ENACRobotique/PAMIS/README.md

# PAMIS_2024

Limiter le courant des stepper à 0.6 A

Enlever les solder bridges SB9 SB16 et SB18 de la nucleo L432KC
