ENACRobotique/PAMIS/2026/pamis_2026/README.md

# PAMIs 2026

Carte basée sur un ESP32-S3.

- [ESP-IDF installation Guide](https://docs.espressif.com/projects/esp-idf/en/latest/esp32/get-started/linux-setup.html)

# Configuration

Lancer le "SDK Configuration Editor", et configurer le SSID et le mot de passe du réseau WiFi auquel le PAMI doit se connecter.
