ENACRobotique/PAMIS/2026/pamis_2026/data/low_res.png

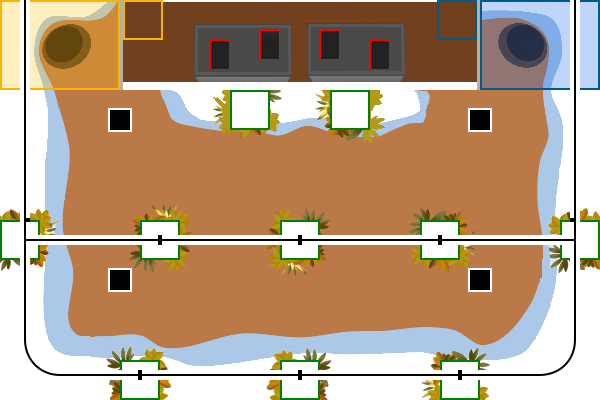
2026/pamis_2026/data/low_res.png
