ENACRobotique/PAMIS/2024/PAMI_soft/schematic.pdf

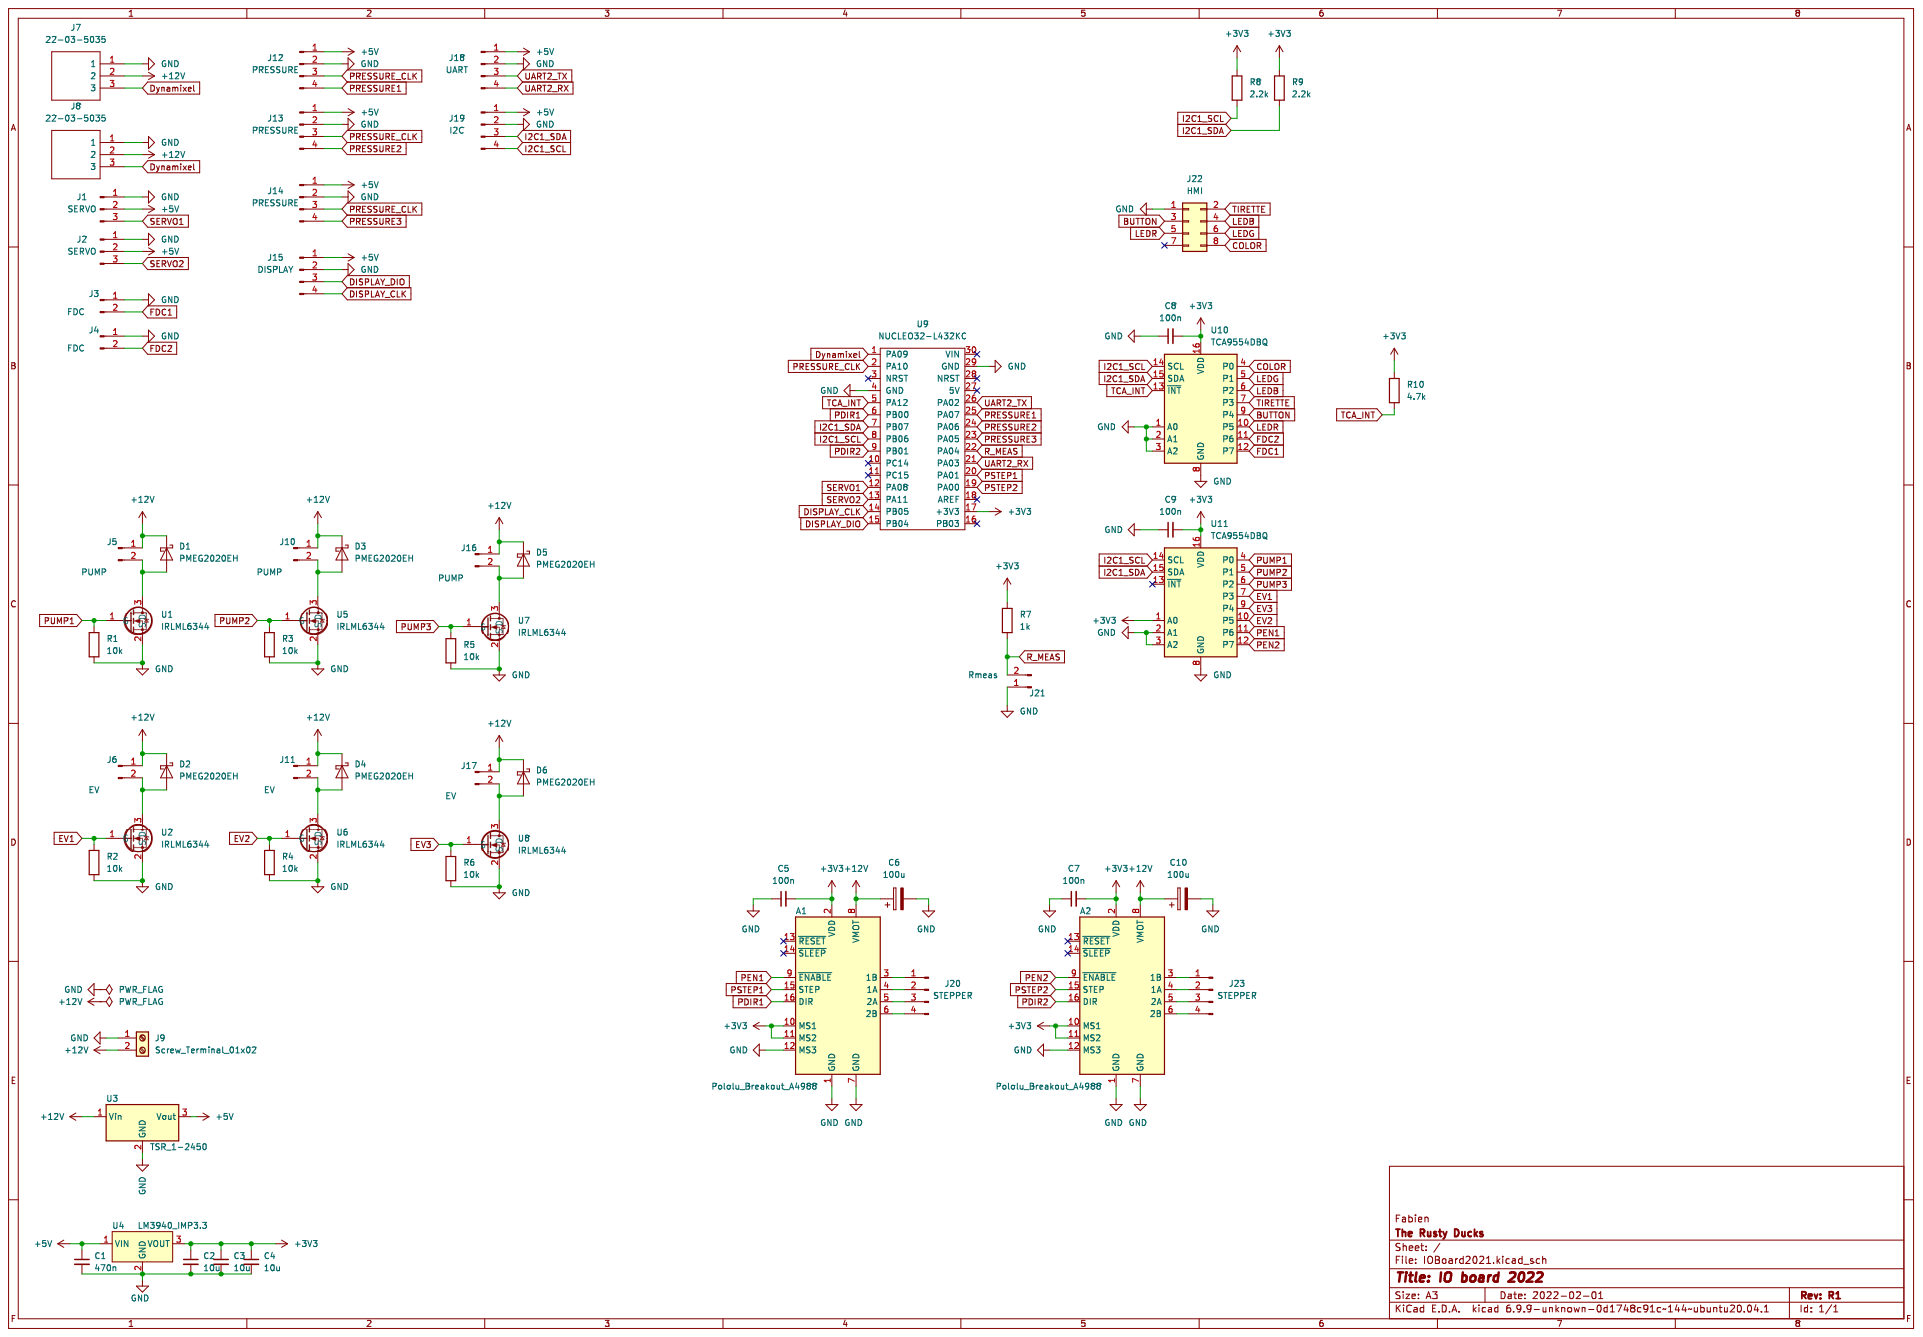
[picture p2: page 1]
