ENACRobotique/PAMIS/2025/carte_elec/pami.kicad_pcb

## KiCad design 2025/carte_elec/pami.kicad_pcb (2025-02-17)

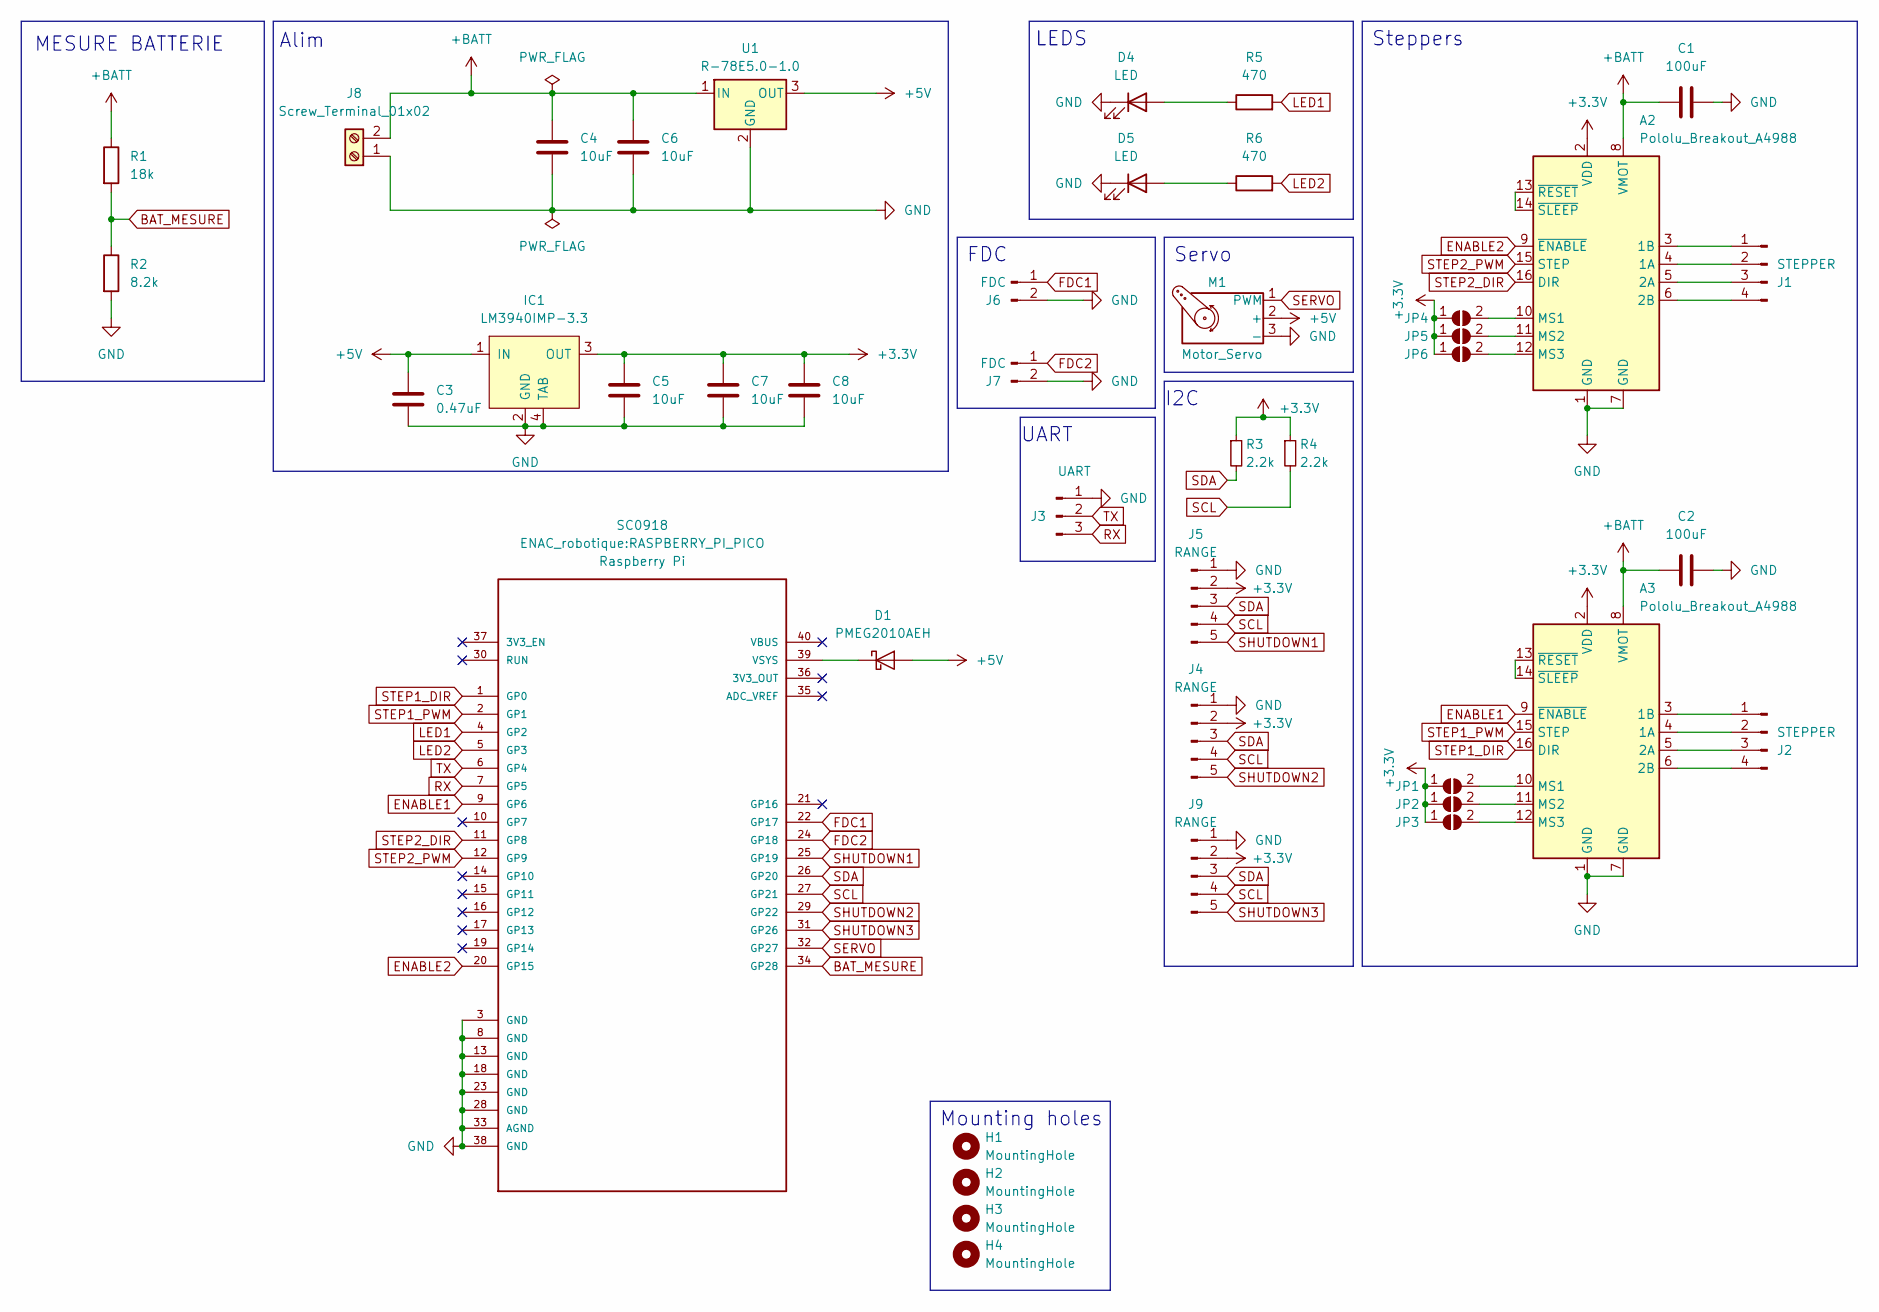
[picture p3: schematic pami.kicad_sch]

Parts:
A1: SC0918; RASPBERRY_PI_PICO; PARTREV 1.6
A2, A3: Pololu_Breakout_A4988; Pololu_Breakout-16_15.2x20.3mm
C1, C2: 100uF; CP_Elec_10x12.5
C3: 0.47uF; C_0805_2012Metric
C4, C5, C6, C7, C8: 10uF; C_0805_2012Metric
D1: PMEG2010AEH; D_SOD-123F
D4, D5: LED; LED_0603_1608Metric
H1, H2, H3, H4: MountingHole; MountingHole_3.2mm_M3
IC1: LM3940IMP-3.3; LM3940IMP
J1, J2: STEPPER; PinHeader_1x04_P2.54mm_Vertical
J3: UART; PinHeader_1x03_P2.54mm_Vertical
J4, J5, J9: RANGE; Molex_PicoBlade_53398-0571_1x05-1MP_P1.25mm_Vertical
J6, J7: FDC; PinHeader_1x02_P2.54mm_Vertical
J8: Screw_Terminal_01x02; TerminalBlock_bornier-2_P5.08mm
JP1, JP2, JP3, JP4, JP5, JP6: SolderJumper_2_Open; SolderJumper-2_P1.3mm_Open_TrianglePad1.0x1.5mm
M1: Motor_Servo; PinHeader_1x03_P2.54mm_Vertical
R1: 18k; R_0603_1608Metric
R2: 8.2k; R_0603_1608Metric
R3, R4: 2.2k; R_0805_2012Metric
R5, R6: 470; R_0603_1608Metric
U1: R-78E5.0-1.0; Converter_DCDC_RECOM_R-78E-0.5_THT

Connections:
+3.3V: A2.2 (VDD), A3.2 (VDD), C5.1, C7.1, C8.1, IC1.3 (OUT), J4.2, J5.2, J9.2, JP1.1 (A), JP2.1 (A), JP3.1 (A), JP4.1 (A), JP5.1 (A), JP6.1 (A), R3.1, R4.1
+5V: C3.1, D1.2 (A), IC1.1 (IN), M1.2 (+), U1.3 (OUT); also elsewhere on the board
+BATT: A2.8 (VMOT), A3.8 (VMOT), C1.1, C2.1, C4.2, C6.2, J8.2, R1.1, U1.1 (IN); also elsewhere on the board
BAT_MESURE: A1.34 (GP28), R1.2, R2.1
ENABLE1: A1.9 (GP6), A3.9 (~ENABLE)
ENABLE2: A1.20 (GP15), A2.9 (~ENABLE)
FDC1: A1.22 (GP17), J6.1; also elsewhere on the board
FDC2: A1.24 (GP18), J7.1; also elsewhere on the board
GND: A1.3 (GND), A1.8 (GND), A1.13 (GND), A1.18 (GND), A1.23 (GND), A1.28 (GND), A1.33 (AGND), A1.38 (GND), A2.1 (GND), A2.7 (GND), A3.1 (GND), A3.7 (GND), C1.2, C2.2, C3.2, C4.1, C5.2, C6.1, C7.2, C8.2, D4.1 (K), D5.1 (K), IC1.2 (GND), IC1.4 (TAB), J3.1, J4.1, J5.1, J6.2, J7.2, J8.1, J9.1, M1.3 (-), R2.2, U1.2 (GND); also elsewhere on the board
LED1: A1.4 (GP2), R5.2
LED2: A1.5 (GP3), R6.2
unnamed: A1.39 (VSYS), D1.1 (K)
unnamed: A2.4 (1A), J1.2
unnamed: A2.3 (1B), J1.1
unnamed: A2.5 (2A), J1.3
unnamed: A2.6 (2B), J1.4
unnamed: A2.10 (MS1), JP4.2 (B)
unnamed: A2.11 (MS2), JP5.2 (B)
unnamed: A2.12 (MS3), JP6.2 (B)
unnamed: A2.13 (~RESET), A2.14 (~SLEEP)
unnamed: A3.4 (1A), J2.2
unnamed: A3.3 (1B), J2.1
unnamed: A3.5 (2A), J2.3
unnamed: A3.6 (2B), J2.4
unnamed: A3.10 (MS1), JP1.2 (B)
unnamed: A3.11 (MS2), JP2.2 (B)
unnamed: A3.12 (MS3), JP3.2 (B)
unnamed: A3.13 (~RESET), A3.14 (~SLEEP)
unnamed: D4.2 (A), R5.1
unnamed: D5.2 (A), R6.1
RX: A1.7 (GP5), J3.3
SCL: A1.27 (GP21), J4.4, J5.4, J9.4, R4.2
SDA: A1.26 (GP20), J4.3, J5.3, J9.3, R3.2
SERVO: A1.32 (GP27), M1.1 (PWM)
SHUTDOWN1: A1.25 (GP19), J5.5
SHUTDOWN2: A1.29 (GP22), J4.5
SHUTDOWN3: A1.31 (GP26), J9.5
STEP1_DIR: A1.1 (GP0), A3.16 (DIR)
STEP1_PWM: A1.2 (GP1), A3.15 (STEP)
STEP2_DIR: A1.11 (GP8), A2.16 (DIR)
STEP2_PWM: A1.12 (GP9), A2.15 (STEP)
TX: A1.6 (GP4), J3.2

Notes on the sheet:
Steppers
FDC
I2C
LEDS
Alim
Servo
UART
Mounting holes
MESURE BATTERIE

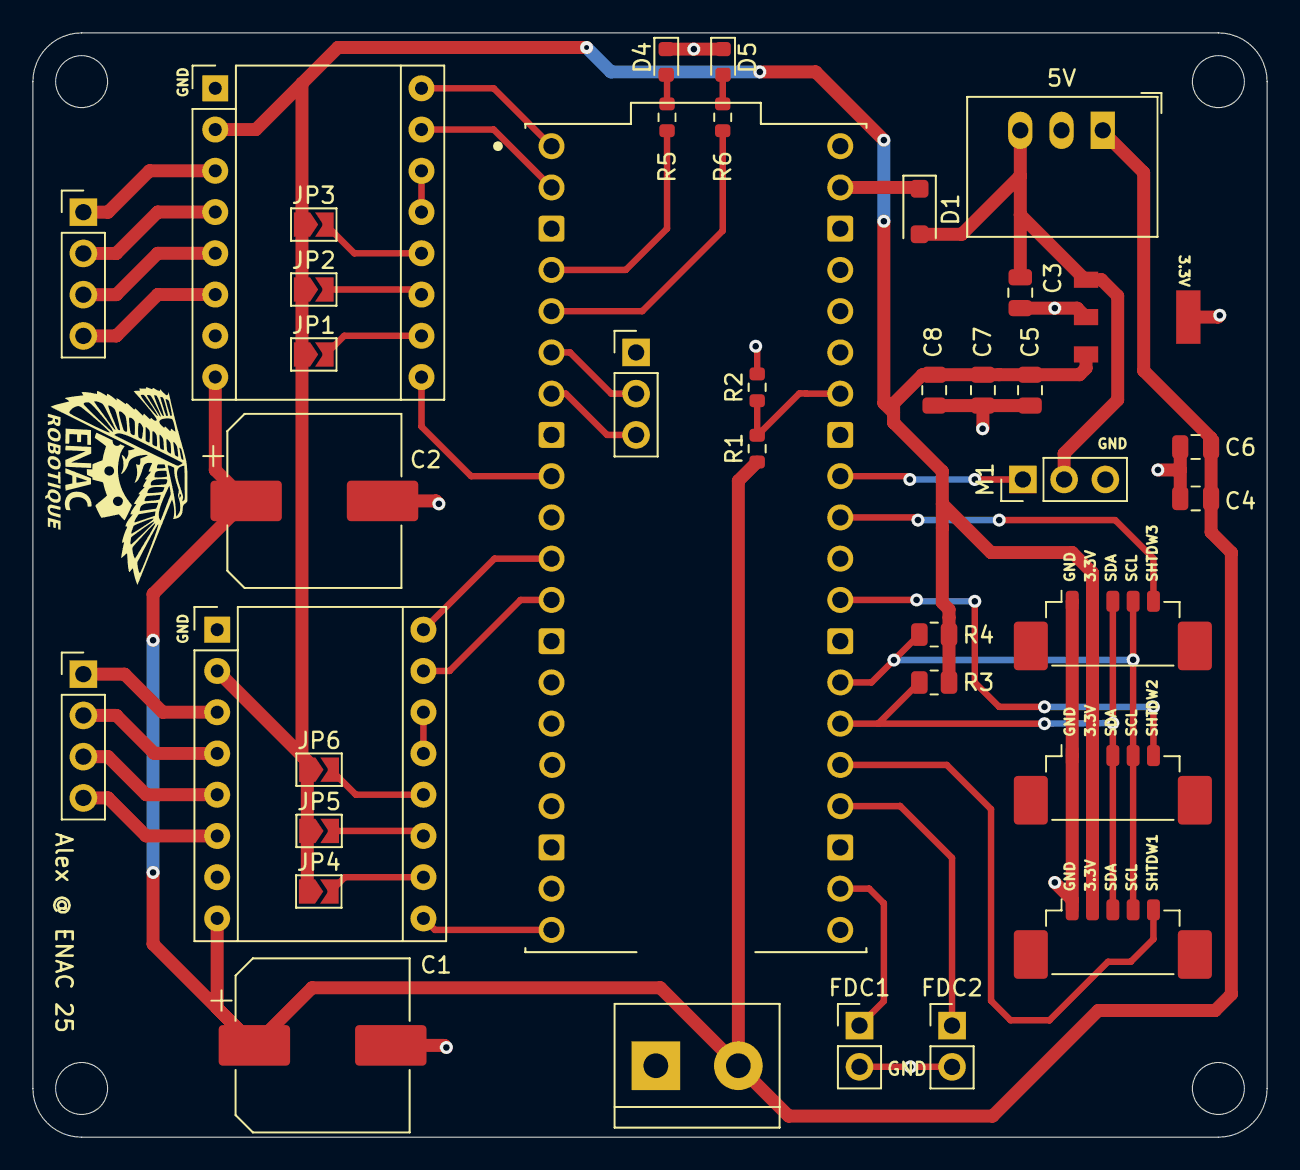
[picture p4: board pami.kicad_pcb from above]

Board: 2 copper layers, 76.0 x 68.0 mm, 42 parts (0 on the bottom side), 42 nets.

Other parts of the board:
5V: R-78E5.0-1.0; Converter_DCDC_RECOM_R-78E-0.5_THT
FDC1, FDC2: FDC; PinHeader_1x02_P2.54mm_Vertical

Their connections:
+5V: 5V.3 (OUT); also elsewhere on the board
+BATT: 5V.1 (IN); also elsewhere on the board
FDC1: FDC1.1; also elsewhere on the board
FDC2: FDC2.1; also elsewhere on the board
GND: 5V.2 (GND), FDC1.2, FDC2.2; also elsewhere on the board
