ENACRobotique/PAMIS/2024/carte_pami/carte_pami.kicad_pcb

## KiCad design 2024/carte_pami/carte_pami.kicad_pcb (2023-12-06)

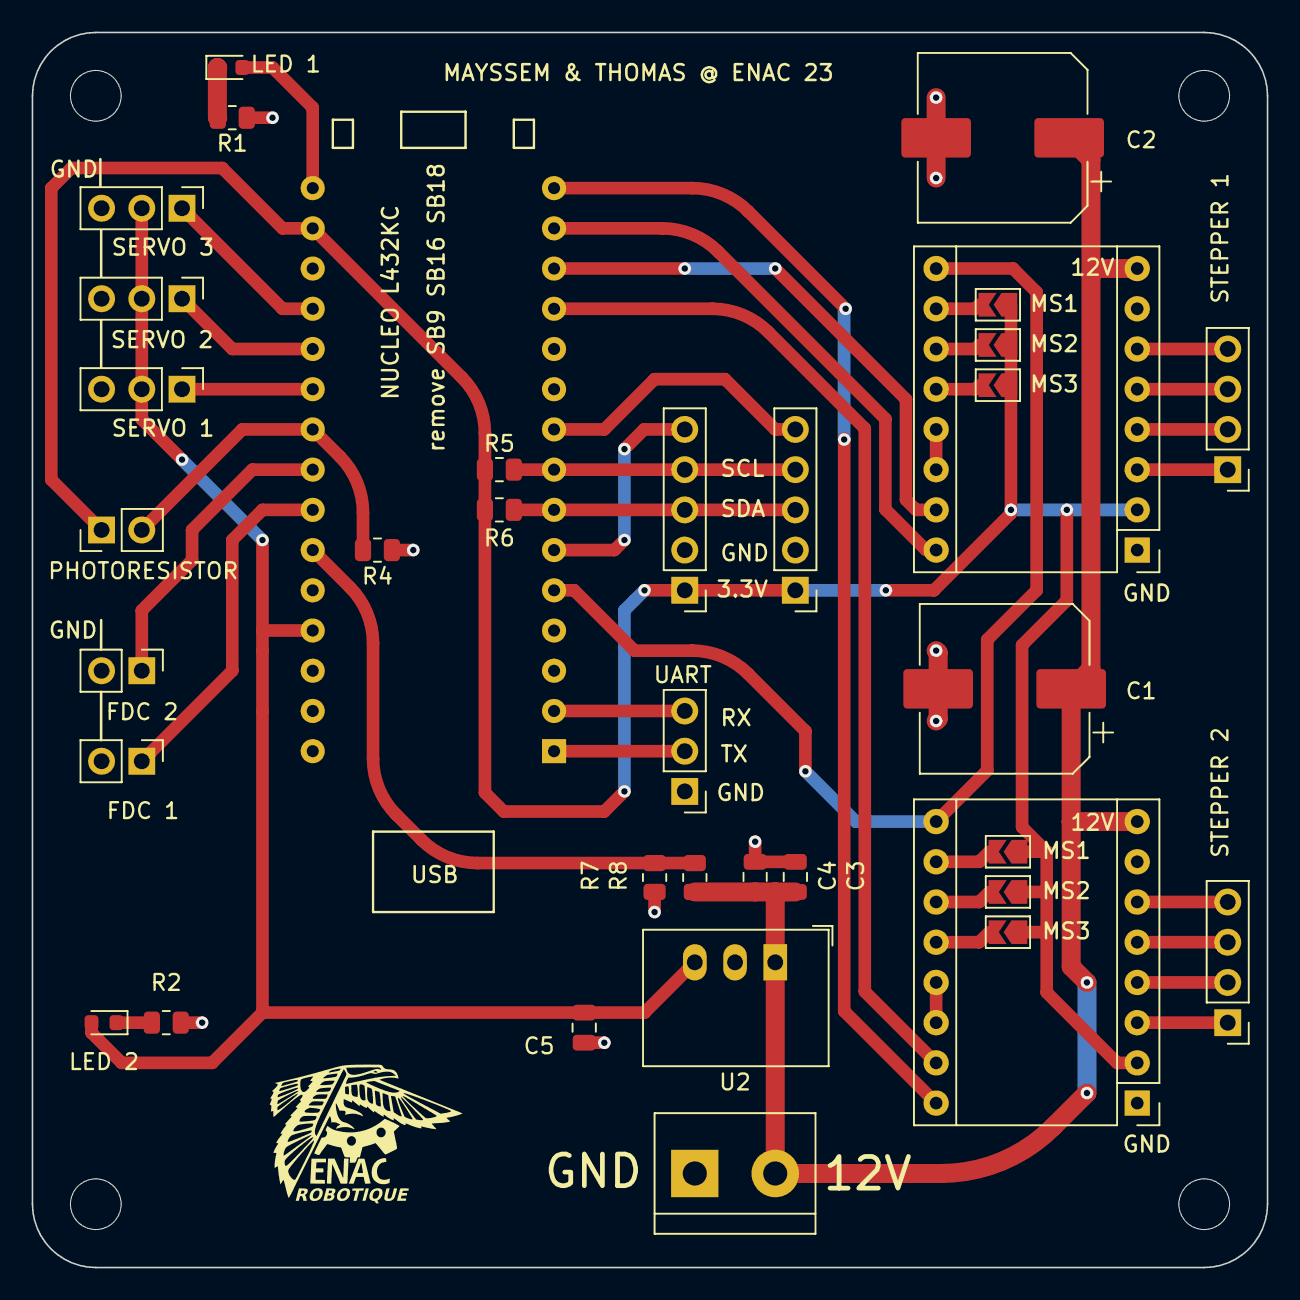
[picture p5: board carte_pami.kicad_pcb from above]

Board: 2 copper layers, 78.0 x 78.0 mm, 40 parts (0 on the bottom side), 41 nets.

Parts:
12V: Screw_Terminal_01x02; TerminalBlock_bornier-2_P5.08mm
C1, C2: 100uF; CP_Elec_10x12.5
C3, C4, C5: 10uF; C_0805_2012Metric
FDC 1, FDC 2: FDC; PinHeader_1x02_P2.54mm_Vertical
H1, H2, H3, H4: MountingHole; MountingHole_3.2mm_M3
J3, J7: RANGE; PinHeader_1x05_P2.54mm_Vertical
JP1, JP2, JP3, JP4, JP5, JP6: SolderJumper_2_Open; SolderJumper-2_P1.3mm_Open_TrianglePad1.0x1.5mm
LED 1, LED 2: LED; LED_0603_1608Metric
M1, M2, M3: Motor_Servo; PinHeader_1x03_P2.54mm_Vertical
PHOTORESISTOR: R_Photo; PinHeader_1x02_P2.54mm_Vertical
R1, R2: 500; R_0805_2012Metric
R4, R7: 10k; R_0805_2012Metric
R5, R6: 2.2k; R_0805_2012Metric
R8: 35k; R_0805_2012Metric
STEPPER 1, STEPPER 2#2: Pololu_Breakout_A4988; Pololu_Breakout-16_15.2x20.3mm
STEPPER 1#2, STEPPER 2: STEPPER; PinHeader_1x04_P2.54mm_Vertical
U1: NUCLEO32-L432KC; NUCLEO32
U2: R-78E5.0-1.0; Converter_DCDC_RECOM_R-78E-0.5_THT
UART: UART; PinHeader_1x03_P2.54mm_Vertical

Connections:
+3.3V: J3.1, J7.1, JP1.1 (A), JP2.1 (A), JP3.1 (A), JP4.1 (A), JP5.1 (A), JP6.1 (A), PHOTORESISTOR.1, R5.1, R6.1, STEPPER 1.2 (VDD), STEPPER 2#2.2 (VDD), U1.17 (+3V3)
+5V: C5.2, LED 2.2 (A), M1.2 (+), M2.2 (+), M3.2 (+), U1.27 (5V), U2.3 (OUT)
ALIM: 12V.2, C1.1, C2.1, C3.2, C4.2, R8.2, STEPPER 1.8 (VMOT), STEPPER 2#2.8 (VMOT), U2.1 (IN)
ENABLE: STEPPER 1.9 (~ENABLE), STEPPER 2#2.9 (~ENABLE), U1.5 (PA12)
FDC1: FDC 1.1, U1.24 (PA06)
FDC2: FDC 2.1, U1.23 (PA05)
GND: 12V.1, C1.2, C2.2, C3.1, C4.1, C5.1, FDC 1.2, FDC 2.2, J3.2, J7.2, M1.3 (-), M2.3 (-), M3.3 (-), R1.2, R2.1, R4.1, R7.1, STEPPER 1.1 (GND), STEPPER 1.7 (GND), STEPPER 2#2.1 (GND), STEPPER 2#2.7 (GND), U1.4 (GND), U1.29 (GND), U2.2 (GND), UART.1
LED: LED 1.2 (A), U1.16 (PB03)
MEAS_BAT: R7.2, R8.1, U1.25 (PA07)
MEAS_LIGHT: PHOTORESISTOR.2, R4.2, U1.22 (PA04)
unnamed: STEPPER 1.4 (1A), STEPPER 1#2.2
unnamed: STEPPER 1.3 (1B), STEPPER 1#2.1
unnamed: STEPPER 1.5 (2A), STEPPER 1#2.3
unnamed: STEPPER 1.6 (2B), STEPPER 1#2.4
unnamed: JP6.2 (B), STEPPER 1.10 (MS1)
unnamed: JP5.2 (B), STEPPER 1.11 (MS2)
unnamed: JP4.2 (B), STEPPER 1.12 (MS3)
unnamed: STEPPER 1.13 (~RESET), STEPPER 1.14 (~SLEEP)
unnamed: STEPPER 2.2, STEPPER 2#2.4 (1A)
unnamed: STEPPER 2.1, STEPPER 2#2.3 (1B)
unnamed: STEPPER 2.3, STEPPER 2#2.5 (2A)
unnamed: STEPPER 2.4, STEPPER 2#2.6 (2B)
unnamed: JP1.2 (B), STEPPER 2#2.10 (MS1)
unnamed: JP2.2 (B), STEPPER 2#2.11 (MS2)
unnamed: JP3.2 (B), STEPPER 2#2.12 (MS3)
unnamed: STEPPER 2#2.13 (~RESET), STEPPER 2#2.14 (~SLEEP)
unnamed: LED 2.1 (K), R2.2
unnamed: LED 1.1 (K), R1.1
RX: U1.2 (PA10), UART.3
SCL: J3.4, J7.4, R5.2, U1.8 (PB06)
SDA: J3.3, J7.3, R6.2, U1.7 (PB07)
SERVO1: M1.1 (PWM), U1.21 (PA03)
SERVO2: M2.1 (PWM), U1.20 (PA01)
SERVO3: M3.1 (PWM), U1.19 (PA00)
SHUTDOWN1: J3.5, U1.9 (PB01)
SHUTDOWN2: J7.5, U1.6 (PB00)
STEP1_DIR: STEPPER 2#2.16 (DIR), U1.15 (PB04)
STEP1_PWM: STEPPER 2#2.15 (STEP), U1.12 (PA08)
STEP2_DIR: STEPPER 1.16 (DIR), U1.14 (PB05)
STEP2_PWM: STEPPER 1.15 (STEP), U1.13 (PA11)
TX: U1.1 (PA09), UART.2
