ENACRobotique/PAMIS/2026/pamis_2026/main/locomotion.h

#pragma once

#include <limits>
#include "stepper.h"
#include "radar_vl53.h"

struct Position
{
    float x;
    float y;
    float theta;
};

struct DistancesRoues
{
    float d1;
    float d2;
};

enum mvm_status
{
    IDLE_mvm,
    TURN_mvm,
    CRUISE_mvm,
    TURN_FINAL_mvm,
};

struct LocomParam
{
    float wheelbase;
    float steps_per_mm;
};

class Locomotion
{
public:
    void init(LocomParam mes_parametres);

    void move(float lenght, float angle);
    void set_wheelbase(int pami_id);
    volatile bool trajectoire_en_cours = false;

    void moveBlocking(float lenght, float angle);
    DistancesRoues stop(double braking_distance = std::numeric_limits<double>::max());
    DistancesRoues leg(DistancesRoues d);
    void moveEvitement(float d, float alpha);
    void set_speed(float v, float a);
    void resumeTrajectory();
    void abortTrajectory();
    void pauseTrajectory();
    void enableSteppers(bool enable);

    bool moving();

    Position getPos() { return pos; }
    void setPos(Position new_pos) { pos = new_pos; }

    float getPosLeft()
    {
        return step_left.getPositionMm();
    }

    float getPosRight()
    {
        return step_right.getPositionMm();
    }

    static void odometry_task(void *arg);

    static void trajectory_task(void *arg);
    /**
     * @param milliseconds timeout in milliseconds; omit it to wait indefinitely
     * @return pdTRUE if move finished, or pdFALSE on timeout
     */
    BaseType_t waitFinishedTimeout(uint32_t milliseconds = portMAX_DELAY);

    void trajectory(Position *dest, int nb_pts);

    int trajectory_movement();

    void setMatchStart();
    Position pos;

    TickType_t match_start_time;
    float vitesse_pami;
    float acceleration_pami;

private:
    void _move(float d1, float d2);
    Stepper step_left;
    Stepper step_right;

    float current_wheelbase;
    float current_steps_per_mm;

    float oldPosLeft;
    float oldPosRight;

    // mvm_status -> enum ?? -> mvm_status mvm_etat = IDLE
    // Il faut éviter d'avoir des doublons de IDLE : stepper et locomotion ??
    mvm_status mvm_etat = IDLE_mvm;

    SemaphoreHandle_t traj_sem;
    Position traj_points[200];
    int traj_length;
    TaskHandle_t traj_TaskHandle = NULL;
    bool is_aborted = true;
};

extern Locomotion locomotion;
