ENACRobotique/PAMIS/2025/code_PAMI_2025/src/config.h

#pragma once

// // #define BOWIE
//#define STEVE
#define JOHNNY
//#define JIMMY

#define DISTANCEEVITEMENT 100
#define DISTANCEEVITEMENT_JHONNY 100

#undef LED1
#define LED1 2

#undef LED2
#define LED2 3

#define UARTTX 4
#define UARTRX 5

#define ENABLE2 15
#define DIR2 8
#define STEP2 9

#define ENABLE1 6
#define DIR1 0
#define STEP1 1

#define FDC1 17
#define FDC2 18

#define SHUTDOWN1 19
#define SHUTDOWN2 22
#define SHUTDOWN3 26
#define SDA 20
#define SCL 21

#define SERVO 27

#define BAT_MESURE 28

#define TIRETTE FDC2
