ENACRobotique/PAMIS/2026/pamis_2026/main/locomotion.cpp

#include "locomotion.h"
#include "stepper.h"
#include "config.h"
#include "utils.h"
#include "sts3032.h"
#include "radar_vl53.h"
#include "esp_log.h"
#include "strat.h"

// 1.8° per step, wheel 3inch diameter
constexpr double STEPS_PER_MM = (360.0 / 1.8) / (M_PI * 71);

// constexpr float WHEELBASE = 123.2; // mm pour les fondations
constexpr float WHEELBASE = 97.8; // mm pour wallid

float longueur_caisse = 150; // mm

bool arret_urgence = false;

Locomotion locomotion;

Stepper_config_t step_cfg = {
    .stepPin = 39,
    .dirPin = 38,
    .enPin = 40,
    .miStep = MICROSTEP_16
};

Stepper_config_t step2_cfg = {
    .stepPin = 36,
    .dirPin = 35,
    .enPin = 40,
    .miStep = MICROSTEP_16
};

void Locomotion::init(LocomParam parametre)
{

    pos = {0, 0, 0};
    match_start_time = 0;

    traj_sem = xSemaphoreCreateBinary();

    current_wheelbase = parametre.wheelbase;
    current_steps_per_mm = parametre.steps_per_mm;

    step_left.config(&step_cfg);
    step_left.init();
    step_left.setStepsPerMm(current_steps_per_mm);
    step_left.setSpeedMm(1000, 4000);
    step_right.config(&step2_cfg);
    step_right.init();
    step_right.setStepsPerMm(current_steps_per_mm);
    step_right.setSpeedMm(1000, 4000);
    radar_vl53::set_seuils(0, 0, 0, 0, 0);

    oldPosLeft = getPosLeft();
    oldPosRight = getPosRight();

    xTaskCreate(odometry_task, "Odometry", configMINIMAL_STACK_SIZE + 1024, this, 2, NULL);
    xTaskCreate(trajectory_task, "Trajectory", configMINIMAL_STACK_SIZE + 1024, this, 2, &traj_TaskHandle);
}

void Locomotion::resumeTrajectory()
{
    arret_urgence = false;
    enableSteppers(true);
    if (traj_TaskHandle != NULL)
    {
        vTaskResume(traj_TaskHandle);
    }
}

void Locomotion::abortTrajectory()
{
    is_aborted = true;
    mvm_etat = IDLE_mvm;
}

void Locomotion::pauseTrajectory()
{
    arret_urgence = true;
    float step_to_do_left = step_left.stop();
    float step_to_do_right = step_right.stop();
    if (traj_TaskHandle != NULL)
    {
        vTaskSuspend(traj_TaskHandle);
    }
}

DistancesRoues Locomotion::stop(double braking_distance)
{
    // arret lent
    float step_to_do_left = step_left.stop(braking_distance);
    float step_to_do_right = step_right.stop(braking_distance);
    waitFinishedTimeout(1000);
    DistancesRoues d = {
        .d1 = step_to_do_left,
        .d2 = step_to_do_right
    };
    return d;
}

void Locomotion::moveBlocking(float lenght, float angle)
{
    move(lenght, angle);
    waitFinishedTimeout();
}

void Locomotion::move(float d, float alpha)
{

    float d1 = d - (current_wheelbase / 2) * alpha;
    float d2 = d + (current_wheelbase / 2) * alpha;

    _move(d1, d2);
}

void Locomotion::_move(float d1, float d2)
{

    float acc = 0;
    float v1 = 0;
    float v2 = 0;
    float d = (d1 + d2) / 2;
    if (d == 0)
    {
        v1 = vitesse_pami;
        v2 = vitesse_pami;
        acc = acceleration_pami;
    }
    else
    {
        v1 = abs(d1 / d) * vitesse_pami;
        v2 = abs(d2 / d) * vitesse_pami;
        acc = abs(d1 / d) * acceleration_pami;
    }

    step_left.setSpeedMm(v1, acc);
    step_right.setSpeedMm(v2, acc);
    step_left.runPosMm(d1);
    step_right.runPosMm(d2);
}



void Locomotion::enableSteppers(bool enable)
{
    if (enable)
    {
        step_left.enableMotor();
        step_right.enableMotor();
    }
    else
    {
        step_left.disableMotor();
        step_right.disableMotor();
    }
}


bool Locomotion::moving()
{
    bool left_moving = step_left.getState() != motor_status::IDLE && step_left.getState() != motor_status::DISABLED;
    bool right_moving = step_right.getState() != motor_status::IDLE && step_right.getState() != motor_status::DISABLED;
    return left_moving || right_moving;
}

void Locomotion::trajectory(Position *dest, int nb_pts)
{

    // Question: si la traj précédente n'est pas finie, qu'est-ce qu'on fait ?
    // - rien (on continue l'ancienne), et on retourne une erreur ?
    // - on s'arrête, puis on fait la nouvelle trajectoire ?
    // Comment définir si on a fini ? mettre une valeur particulière pour traj_length ou regarder l'état du déplacement (Idle, turn_final...)?

    traj_length = nb_pts;
    // on va éviter de faire des mallocs pour les trucs "critiques" en embarqué.
    // donc soit on réserve un tableau de Position assez grand (10 c'est déjà bien) dans Locomotion,
    // soit on stocke directement le pointeur qu'on nous donne, mais ça implique qu'il
    // doit rester valable pour toute la durée d'exécution de la boucle.
    // le plus simple c'est davoir un tableau interne assez grand et d'y copier les positions
    for (int i = 0; i < nb_pts; i++)
    {
        traj_points[i] = dest[i];
    }

    // On "demande" à faire une action
    xSemaphoreGive(traj_sem);
}

void Locomotion::odometry_task(void *arg)
{
    Locomotion *that = static_cast<Locomotion *>(arg);

    while (true)
    {
        float pos_left = that->getPosLeft();
        float pos_right = that->getPosRight();

        float dLeft = pos_left - that->oldPosLeft;
        float dRight = pos_right - that->oldPosRight;
        float dTheta = (dRight - dLeft) / that->current_wheelbase;
        float d = (dRight + dLeft) / 2;
        that->oldPosLeft = pos_left;
        that->oldPosRight = pos_right;

        // ancienne position
        Position pos = that->getPos();

        pos.x += d * cos(pos.theta + dTheta / 2);
        pos.y += d * sin(pos.theta + dTheta / 2);
        pos.theta += dTheta;
        pos.theta = normalise(pos.theta);

        that->setPos(pos);

        // sleep jusqu'à la prochaine période
        utils::sleep(ODOMETRY_PERIOD_MS);
    }
}

int Locomotion::trajectory_movement()
{
    trajectoire_en_cours = true;
    int i = 0;
    while (i < traj_length)
    {
        uint32_t temps_ecoule_ms = (xTaskGetTickCount() - match_start_time) * portTICK_PERIOD_MS;

        if (temps_ecoule_ms >= 99000 && match_start_time != 0)
        {
            stop();
            trajectoire_en_cours = false;
            break;
        }
        utils::sleep(10);
        if (arret_urgence)
        {
            utils::sleep(50);
            mvm_etat = IDLE_mvm;
            continue;
        }
        bool is_finished = waitFinishedTimeout(100);

        switch (mvm_etat)
        {
        case IDLE_mvm:
        {
            mvm_etat = TURN_mvm;
            float dx = traj_points[i].x - pos.x;
            float dy = traj_points[i].y - pos.y;
            float d_theta = normalise(atan2(dy, dx) - pos.theta);
            move(0, d_theta);
            break;
        }
        case TURN_mvm:
        {
            if (is_finished)
            {
                float dx = traj_points[i].x - pos.x;
                float dy = traj_points[i].y - pos.y;
                float erreur_angle = normalise(atan2(dy, dx) - pos.theta);

                if (abs(erreur_angle) > 0.08f)
                {
                    mvm_etat = IDLE_mvm;
                }
                else
                {
                    mvm_etat = CRUISE_mvm;
                    float mvm_length = sqrtf(dx * dx + dy * dy);
                    move(mvm_length, 0);
                }
            }
            break;
        }
        case CRUISE_mvm:
        {
            if (is_finished)
            {
                float dx = traj_points[i].x - pos.x;
                float dy = traj_points[i].y - pos.y;
                float dist_restante = sqrtf(dx * dx + dy * dy);

                if (dist_restante > 25.0f)
                {
                    mvm_etat = IDLE_mvm;
                }
                else
                {
                    if (i == traj_length - 1)
                    {
                        mvm_etat = TURN_FINAL_mvm;
                        float d_theta = normalise(traj_points[i].theta - pos.theta);
                        move(0, d_theta);
                    }
                    else
                    {
                        i++;
                        mvm_etat = IDLE_mvm;
                    }
                }
            }
            break;
        }
        case TURN_FINAL_mvm:
        {
            if (is_finished)
            {
                trajectoire_en_cours = false;
                step_right.disableMotor();
                step_left.disableMotor();
                return 1;
            }
            break;
        }
        }
    }
    return -1;
}

void Locomotion::setMatchStart()
{
    match_start_time = xTaskGetTickCount();
}

void Locomotion::trajectory_task(void *arg)
{
    Locomotion *that = static_cast<Locomotion *>(arg);

    while (true)
    {
        xSemaphoreTake(that->traj_sem, portMAX_DELAY);

        // Tache à faire
        // Pour chaque point -> lancer un move, waitFinishedTimeout(n ms) pour tester toute les n ms si le mouvement est fini ou s'il y a un soucis
        that->trajectory_movement();
    }
}

BaseType_t Locomotion::waitFinishedTimeout(uint32_t milliseconds)
{
    const TickType_t timeout_ticks = milliseconds == portMAX_DELAY
        ? portMAX_DELAY
        : pdMS_TO_TICKS(milliseconds);

    return step_left.waitFinishedTimeout(timeout_ticks) && step_right.waitFinishedTimeout(timeout_ticks);
}

/**
 * Essaye d'effectuer le mouvement demandé, et retourne ce qu'il manque a faire quand l'évitement l'empêche de bouger.
 * Check l'évitement toutes les 100ms.
 */
DistancesRoues Locomotion::leg(DistancesRoues d)
{
    _move(d.d1, d.d2);
    while (waitFinishedTimeout(100) != pdTRUE)
    {
        if (radar_vl53::danger())
        {
            DistancesRoues d = stop();
            waitFinishedTimeout();
            return d;
        }
    }
    return {0, 0};
}

/**
 * Effectue un mouvement en s'arrêtant au besoin pour l'évitement
 * TODO: ajouter un timeout optionnel ?
 */
void Locomotion::moveEvitement(float d, float alpha)
{
    float d1 = d - (current_wheelbase / 2) * alpha;
    float d2 = d + (current_wheelbase / 2) * alpha;
    DistancesRoues r = {d1, d2};
    ESP_LOGI("MOVE_E", "%f  %f", d1, d2);
    while (r.d1 != 0 || r.d2 != 0)
    {
        ESP_LOGI("MOVE_E", "d1:%f   d2:%f", r.d1, r.d2);
        r = leg(r);
        while (radar_vl53::danger())
        {
            utils::sleep(500);
        }
    }
}

void Locomotion::set_speed(float v, float a)
{
    vitesse_pami = v;
    acceleration_pami = a;
}
