ENACRobotique/PAMIS/2026/pamis_2026/main/radar_vl53.cpp

#include "radar_vl53.h"
#include "vl53l1_platform.h"
#include "freertos/FreeRTOS.h"
#include "freertos/task.h"
#include "driver/gpio.h"
extern "C" {
    #include "VL53L1X_api.h"
}
#include "endian.h"
#include "telelogs.h"
#include "utils.h"

namespace radar_vl53 {


constexpr uint16_t RADAR_NB_RETRY = 5;
uint16_t distances_radars[RADAR_NB];
static float seuils[RADAR_NB] = {};

static i2c_master_bus_handle_t* vl53_bus_handle;

static gpio_config_t radar_sht_conf = {
    .pin_bit_mask = (1 << GPIO_NUM_14) | (1 << GPIO_NUM_21) | (1 << GPIO_NUM_11) | (1 << GPIO_NUM_12) | (1 << GPIO_NUM_13),
    .mode = GPIO_MODE_OUTPUT,
    .pull_up_en = GPIO_PULLUP_DISABLE,
    .pull_down_en = GPIO_PULLDOWN_DISABLE,
    .intr_type = GPIO_INTR_DISABLE,
};

static VL53L1_Dev_t radars[RADAR_NB] = {
    {
        .dev_config = {
            .dev_addr_length = I2C_ADDR_BIT_LEN_7,
            .device_address = 0x29,
            .scl_speed_hz = 400000
        },
        .shutdown_gpio = GPIO_NUM_11,
        .addr = 0x30,
        .actif = true
    },
    {
        .dev_config = {
            .dev_addr_length = I2C_ADDR_BIT_LEN_7,
            .device_address = 0x29,
            .scl_speed_hz = 400000
        },
        .shutdown_gpio = GPIO_NUM_12,
        .addr = 0x31,
        .actif = true
    },
    {
        .dev_config = {
            .dev_addr_length = I2C_ADDR_BIT_LEN_7,
            .device_address = 0x29,
            .scl_speed_hz = 400000
        },
        .shutdown_gpio = GPIO_NUM_13,
        .addr = 0x32,
        .actif = true
    },
    {
        .dev_config = {
            .dev_addr_length = I2C_ADDR_BIT_LEN_7,
            .device_address = 0x29,
            .scl_speed_hz = 400000
        },
        .shutdown_gpio = GPIO_NUM_14,
        .addr = 0x33,
        .actif = true
    },
    {
        .dev_config = {
            .dev_addr_length = I2C_ADDR_BIT_LEN_7,
            .device_address = 0x29,
            .scl_speed_hz = 400000
        },
        .shutdown_gpio = GPIO_NUM_21,
        .addr = 0x34,
        .actif = true
    }
};

static VL53L1X_ERROR init_radar(VL53L1_Dev_t* radar) {
        ESP_ERROR_CHECK(i2c_master_bus_add_device(*vl53_bus_handle, &radar->dev_config, &radar->dev_handle));
        // turn sensor ON
        gpio_set_level(radar->shutdown_gpio,1);
        
        // Wait for device booted
        uint16_t nb_errors = 0;
        while(true){
            uint8_t booted = 0;
            VL53L1X_ERROR status = VL53L1X_BootState(radar, (uint8_t*)&booted);
            if(status == 0 && booted){
                break;
            }
            
            if(status) {
                if(nb_errors++ > RADAR_NB_RETRY) {
                    // too many I2C errors, disable this radar and abort init
                    // TODO raise an error somewhere ?
                    radar->actif = false;
                    return VL53L1X_ERROR_TIMEOUT;
                }
            }
            utils::sleep(50);
        }

        //sensor initialization
        VL53L1X_SensorInit(radar);

        // change I2C address
        VL53L1X_SetI2CAddress(radar, radar->addr*2);
        radar->dev_config.device_address = radar->addr;
        i2c_master_bus_rm_device(radar->dev_handle);
        ESP_ERROR_CHECK(i2c_master_bus_add_device(*vl53_bus_handle, &radar->dev_config, &radar->dev_handle));

        // if needed, for quicker measurements
        // VL53L1X_SetDistanceMode(radars, 1);
        // VL53L1X_SetTimingBudgetInMs(radars, 20);
        // VL53L1X_SetInterMeasurementInMs(radars, 20);

        // start continuous ranging
        VL53L1X_StartRanging(radar);
        
        return VL53L1X_ERROR_NONE;
}

static VL53L1X_ERROR radar_read(VL53L1_Dev_t* radar,  VL53L1X_Result_t* result)
{
    // wait until data ready
    while (true)
    {
        uint8_t isDataReady = 0;
        VL53L1X_ERROR status = VL53L1X_CheckForDataReady(radar, &isDataReady);
        if (status == VL53L1X_ERROR_NONE)
        {
            if (isDataReady)
            {
                break;
            }
            utils::sleep(20);
        }
        else
        {
            return status;
        }
    }

    VL53L1X_GetResult(radar, result);
    VL53L1X_ClearInterrupt(radar);

    return VL53L1X_ERROR_NONE;
}

uint16_t get_distance(uint16_t radar_nb){
    if(radar_nb<RADAR_NB && radars[radar_nb].actif){
        return(distances_radars[radar_nb]);
    }
    else{
        return(1000000);
    }
}

void set_seuils(float seuil0, float seuil1, float seuil2, float seuil3, float seuil4)
{
    seuils[0] = seuil0;
    seuils[1] = seuil1;
    seuils[2] = seuil2;
    seuils[3] = seuil3;
    seuils[4] = seuil4;
}

// TODO: check seulement les capteurs actifs ?
bool danger()
{
    for (std::size_t i = 0; i < RADAR_NB; ++i)
    {
        if (get_distance(i) <= seuils[i])
        {
            return true;
        }
    }
    return false;
}

static void radarTask(void* arg) {
    // configure GPIO dor shutdown pins
    gpio_config(&radar_sht_conf);

    // shutdown all sensors
    for(int i = 0; i<RADAR_NB; i++){
        gpio_set_level(radars[i].shutdown_gpio,0);
    }
    
    utils::sleep(10);    // be sure that sensor are off
    
    // init sensors
    for(int i = 0; i<RADAR_NB; i++){
        if(radars[i].actif){
            init_radar(&radars[i]);
        }
    }

    while(true) {
        for(int i = 0; i<RADAR_NB; i++){
            if(radars[i].actif){
                VL53L1X_Result_t result;
                VL53L1X_ERROR status = radar_read(&radars[i], &result);
                // check that read succeded and the measurement is valid
                if (status == VL53L1X_ERROR_NONE){
                    if(result.Status == 0){
                        distances_radars[i] = result.Distance;
                    }
                    else{distances_radars[i]=10000;}

                    char name[50];
                    snprintf(name, 50, "dist %d", i);
                    telelogs_send_float(name, result.Distance);

                    // TODO: make this distance accessible

                    // char Ambient[50];
                    // snprintf(Ambient, 50, "Ambient %d", i);
                    // telelogs_send_float(Ambient, result.Ambient);

                    // char SigPerSPAD[50];
                    // snprintf(SigPerSPAD, 50, "SigPerSPAD %d", i);
                    // telelogs_send_float(SigPerSPAD, result.SigPerSPAD);

                    // char NumSPADs[50];
                    // snprintf(NumSPADs, 50, "NumSPADs %d", i);
                    // telelogs_send_float(NumSPADs, result.NumSPADs);
                }
                else {
                    // sensor not responding or bad measurement
                    // TODO: lets consider there are no obstacles ?
                }

                vPortYield();
            }
        }
        
    }
}



void start(i2c_master_bus_handle_t* bus_handle){
    vl53_bus_handle = bus_handle;
    xTaskCreate( radarTask, "radar", configMINIMAL_STACK_SIZE + 1024, NULL, 1, NULL);
}

} // namespace radar_vl53
