ENACRobotique/PAMIS/2026/pamis_2026/main/Astar.h

#pragma once
#include "locomotion.h"

// on défini la map + la taille de la grille
#define LARGEUR_MAP 3000
#define LONGEUR_MAP 2000
#define TAILLE_GRILLE 50

#define GRILLE_LARGEUR (LARGEUR_MAP / TAILLE_GRILLE)
#define GRILLE_LONGEUR (LONGEUR_MAP / TAILLE_GRILLE)

void init_map();
int gestion_point_intermediaire(Position depart, Position arrive, Position waypoints[], int nb_waypoints, Position *chemin_final); 
void ajouter_obstacle_temporaire(Position pos_robot, float distance_mm);
