ENACRobotique/PAMIS/2026/pamis_2026/main/telelogs.cpp

#include "telelogs.h"
#include "esp_log.h"
#include "lwip/err.h"
#include "lwip/sockets.h"
#include "lwip/sys.h"
#include <lwip/netdb.h>
//#include "esp_netif.h"
#define TAG ""

struct sockaddr_in dest_addr;
int addr_family = 0;
int ip_protocol = 0;
struct timeval timeout;
int sock = 0;


void telelogs_init() {
    dest_addr.sin_addr.s_addr = inet_addr("192.168.42.201");
    dest_addr.sin_family = AF_INET;
    dest_addr.sin_port = htons(47269);
    addr_family = AF_INET;
    ip_protocol = IPPROTO_IP;

    sock = socket(addr_family, SOCK_DGRAM, ip_protocol);
    if (sock < 0) {
        ESP_LOGE(TAG, "Unable to create socket: errno %d", errno);
        return;
    }

    // Set timeout
    timeout.tv_sec = 10;
    timeout.tv_usec = 0;
    setsockopt (sock, SOL_SOCKET, SO_RCVTIMEO, &timeout, sizeof timeout);
}

void telelogs_send_string(const char* name, const char* str) {
    char data[500];
    int len = snprintf(data, 500, "%s:%s|t", name, str);
    int err = sendto(sock, data, len, 0, (struct sockaddr *)&dest_addr, sizeof(dest_addr));
    if (err < 0) {
        ESP_LOGE(TAG, "Error occurred during sending: errno %d", errno);
        return;
    }
    //ESP_LOGI(TAG, "Message sent");
}


void telelogs_send_float(const char* name, float value) {
    char buffer[50];
    int len = snprintf(buffer, 50, "%s:%f\n", name, value);
    int err = sendto(sock, buffer, len, 0, (struct sockaddr *)&dest_addr, sizeof(dest_addr));
    //ESP_LOG_BUFFER_CHAR("", buffer, len);
}
