ENACRobotique/PAMIS/2026/pamis_2026/main/utils.cpp

#include "utils.h"
#include "math.h"

float normalise(float angle){
    while(angle < -M_PI){
        angle += 2*M_PI;
    }
    while(angle > M_PI){
        angle -= 2*M_PI;
    }
    return angle;
}
