ENACRobotique/PAMIS/2026/pamis_2026/main/utils.h

#pragma once

#include <cstdint>
#include "freertos/FreeRTOS.h"
#include "freertos/task.h"

namespace utils {

inline void sleep(uint32_t milliseconds)
{
    vTaskDelay(pdMS_TO_TICKS(milliseconds));
}

} // namespace utils

float normalise(float angle);
