ENACRobotique/PAMIS/(commit log)

2023-11-09 Start elec board.
    [carte_pami.kicad_pcb, carte_pami.kicad_sch]
2023-11-16 update carte en cours
    [carte_pami.kicad_sch]
2023-11-23 schematique pami
    [carte_pami.kicad_sch]
2023-11-23 placement composantes
    [carte_pami.kicad_pcb, carte_pami.kicad_sch]
2023-11-25 Petits ajouts au schéma, et définition des capabilities.
    [carte_pami.kicad_pcb, carte_pami.kicad_sch]
2023-11-26 JPO test. Pour la carte "IO board 2022" de Fab@RustyDucks.
2023-11-29 setup right stepper
2023-11-30 commande de déplacement ok
2023-11-30 petit pami fait des rond !
2023-12-01 mesure batterie
    [carte_pami.kicad_pcb, carte_pami.kicad_sch]
2023-12-06 fini le routage de la carte
    [carte_pami.kicad_pcb]
2024-02-01 plus de gpios
    [bom.csv, designators.csv, positions.csv]
2024-02-04 le robot se deplace de points en point
2024-02-09 evitement qui fonctionne et suivi de trajectoire
2024-02-15 adapter pour la nouvelle L432KC
2024-02-16 ommission des points de passage et départ avec photoresistance
2024-02-29 Mesure tension batterie et buzzer.
    [main.cpp]
2024-02-29 réglages PCB
2024-04-26 les VL53L0X sont dans le bon sens
2024-04-27 choix de la stratégie selon l'équipe, ajout du non arret au dernier point, detection grace à la led de l'UCD
2025-02-17 organisation par année
    [bom.csv, carte_pami.kicad_pcb, carte_pami.kicad_sch, designators.csv, positions.csv]
2025-02-17 pamis 2025
    [pami.kicad_pcb, pami.kicad_sch, raspberrypi-swd.cfg]
2025-02-19 test steppers
2025-02-19 Pico: meilleure plateform.
2025-03-24 add odometry + rotate_blocking
2025-03-24 mise a jour odom + debut de fonction move (qui marche pas attention
2025-04-02 move target + resolve bug convert Step2MM
    [locomotion.cpp, locomotion.h, main.cpp]
2025-04-02 peut aller de point en point, pour n points
2025-04-03 avoiding maneouver in progress
    [locomotion.cpp, locomotion.h, main.cpp, radar.cpp, radar.h]
2025-04-07 avoid in progress (non fonctionnel)
    [locomotion.cpp, locomotion.h, main.cpp, radar.cpp]
2025-04-15 suivi des murs fonctionnel
2025-04-24 suiviLignes fixed wrong side when following right to left wall
    [locomotion.cpp]
2025-05-19 accel des pamis + augmentation lisibilité
2025-05-22 tirette delay added +startpos
2025-05-26 better avoidance + parkour
    [main.cpp]
2025-05-29 johnny may go without avoiding partners
    [config.h, locomotion.cpp, main.cpp]
2025-05-29 remove Bowie et changement cible des zones pamis
2025-05-29 nouvelle coord pamis pour coupe + steve dans le code correspond a bowie dans la vrai vie
2026-01-20 begin steppers + convert to C++
2026-01-20 flash with UART
2026-01-21 Fixed-point arithmetics for steppers
    [stepper.cpp, stepper.h]
2026-01-22 Begin Web server
    [partitions.csv]
2026-01-26 Template odometry
2026-01-26 start IMU
2026-02-02 add odometry
2026-02-03 remove test à la con
2026-02-03 fix odometry
2026-02-24 enable IMU back
2026-05-04 Rajout de la fonction stop slow sur le stepper
2026-05-04 Modification de la fonction stop
2026-05-08 Changement des numéros de robot + start ecurueil
2026-05-08 correction de bug apres merge
    [evitement.cpp, locomotion.cpp, locomotion.h, main.cpp, stratWallid.cpp]
2026-05-08 initilisation UART + correction vitesse steppeur
    [main.cpp, strat.cpp]
2026-05-10 Odometrie main + chanegement teleplot html
2026-05-12 queue bougeant fin de match + trajectoire fini (reste a faire évitement annulé pour le PAMI4 qui pousse + tester de lancer les 4 en mm temps)
2026-05-13 changment de la distance pour homologation
2026-09-09 remise en fonction de la Fondation
2026-11-06 steppers cleanup
2026-11-06 [stepper] utilise gpio_ll_set_level plutôt qu'une écriture registre directe.
2026-11-06 [stepper] selectionne phase de mouvement avant calcul du prochain pas.
2026-11-07 [steppers] Fix bugs possible overflow. Ajoute stop(distance)
2026-11-07 doc steppers
2026-11-08 déplace danger() de locomotion vers le radar
2026-11-08 stepper stop unifié
